resolutedreamer/IR-Breakout/README.md

# IR-Breakout
PCB for a small shield for IR communication - for use with SparkFun GPIO Block for Intel® Edison. Designs in Fritzing.
There are 3 different shields - IR receiver, IR emitter, and a shield that fits both the emitter and receiver.
