resolutedreamer/IR-Breakout/emitter-receiver/IR.Emitter-Receiver_bb.png

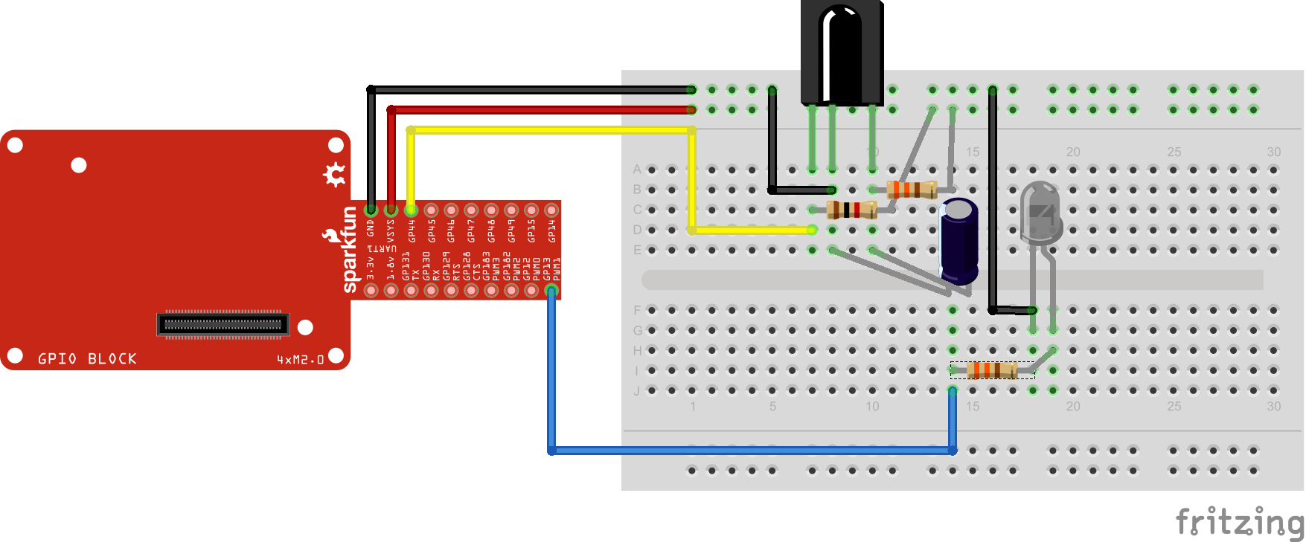
emitter-receiver/IR.Emitter-Receiver_bb.png
