resolutedreamer/IR-Breakout/emitter-receiver/IR.Emitter-Receiver_pcb_bottom.png

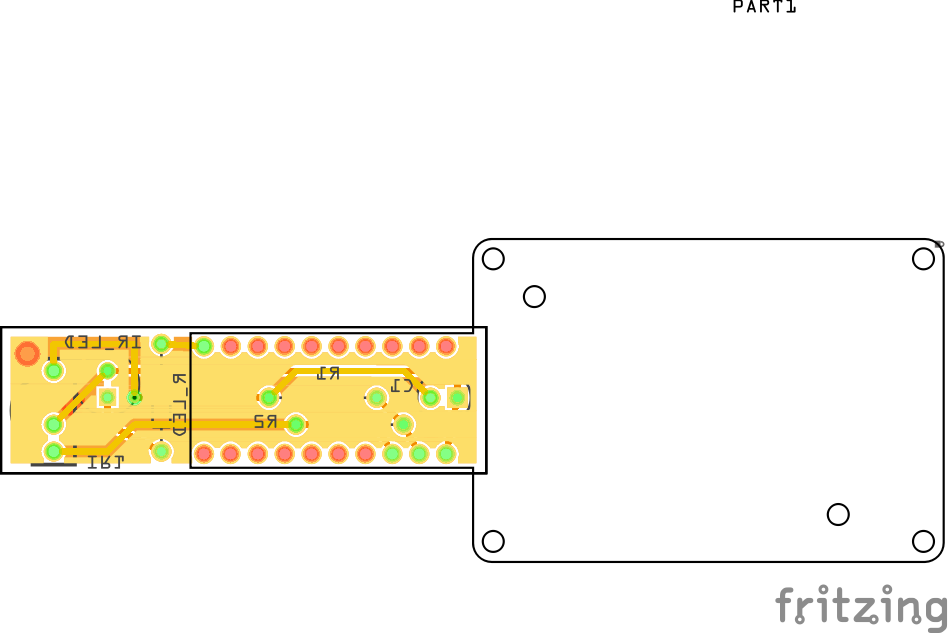
emitter-receiver/IR.Emitter-Receiver_pcb_bottom.png
