resolutedreamer/IR-Breakout/emitter-receiver/IR.Emitter-Receiver_schem.png

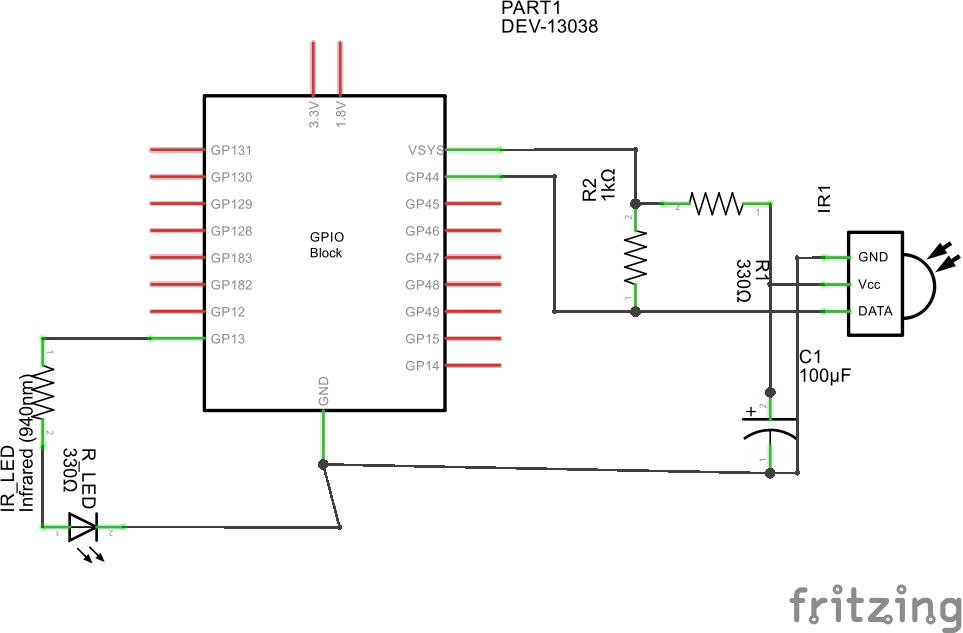
emitter-receiver/IR.Emitter-Receiver_schem.png
