resolutedreamer/IR-Breakout/emitter/IR.Emitter_pcb_bottom.png

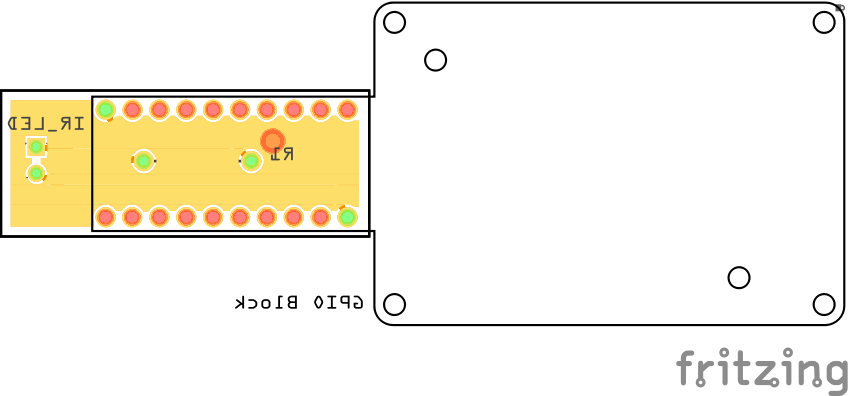
emitter/IR.Emitter_pcb_bottom.png
