resolutedreamer/IR-Breakout/emitter/IR.Emitter_schem.png

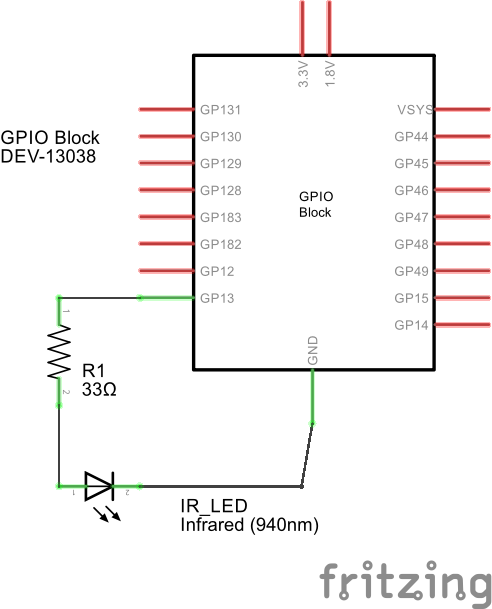
emitter/IR.Emitter_schem.png
