resolutedreamer/IR-Breakout/receiver/TSOP312__.TSOP314__/IR.Receiver.TSOP312__.TSOP314___pcb_bottom.png

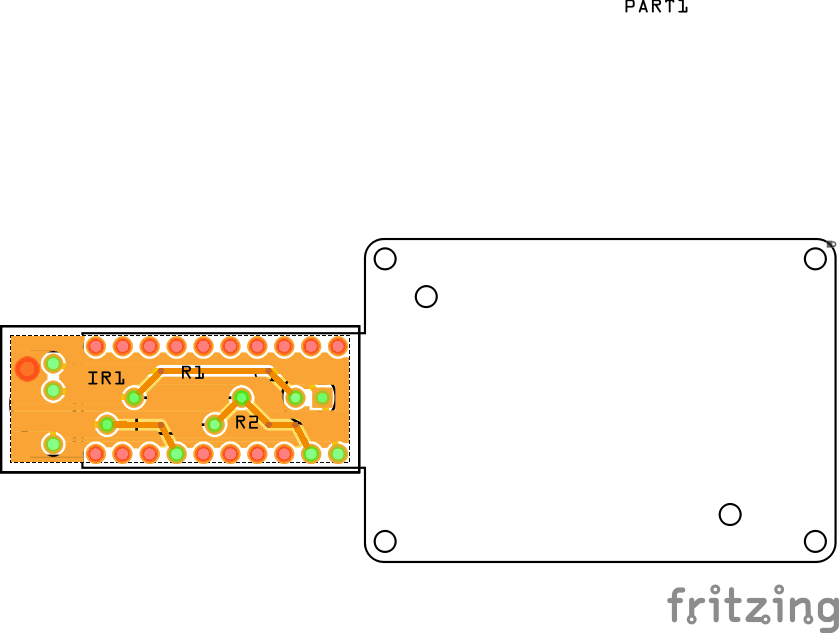
receiver/TSOP312__.TSOP314__/IR.Receiver.TSOP312__.TSOP314___pcb_bottom.png
