resolutedreamer/IR-Breakout/receiver/TSOP312__.TSOP314__/IR.Receiver.TSOP312__.TSOP314___schem.png

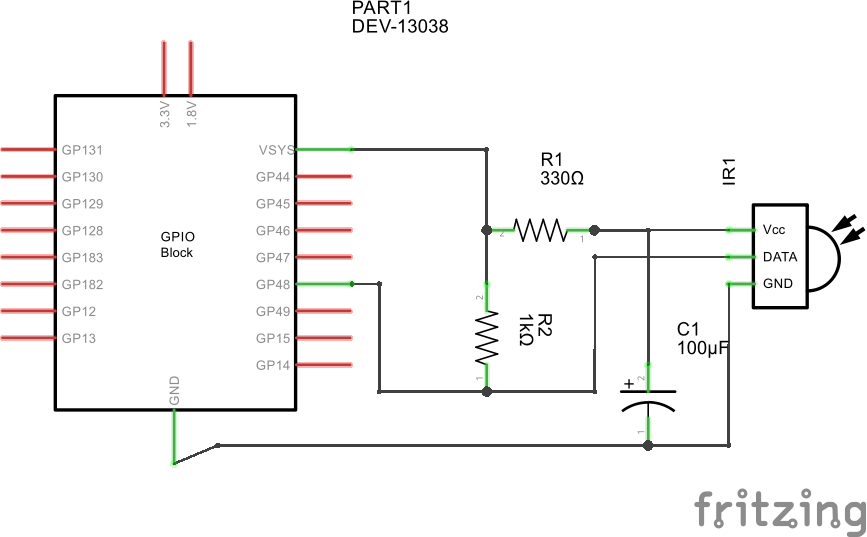
receiver/TSOP312__.TSOP314__/IR.Receiver.TSOP312__.TSOP314___schem.png
