resolutedreamer/IR-Breakout/receiver/TSOP38238/IR.Receiver.TSOP38238_bb.png

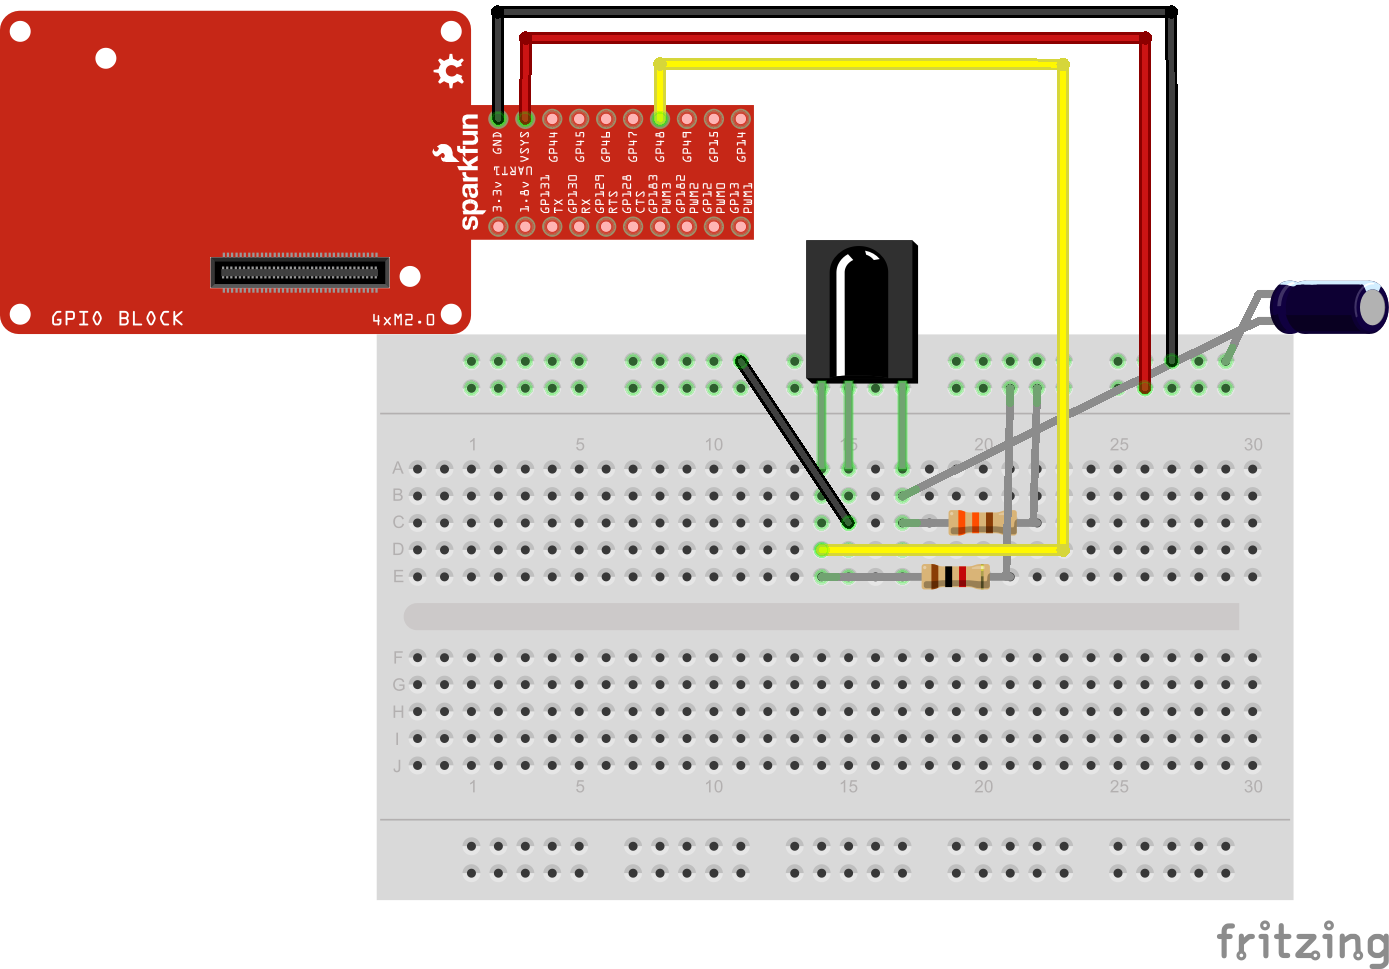
receiver/TSOP38238/IR.Receiver.TSOP38238_bb.png
