resolutedreamer/IR-Breakout/receiver/TSOP38238/IR.Receiver.TSOP38238_schem.png

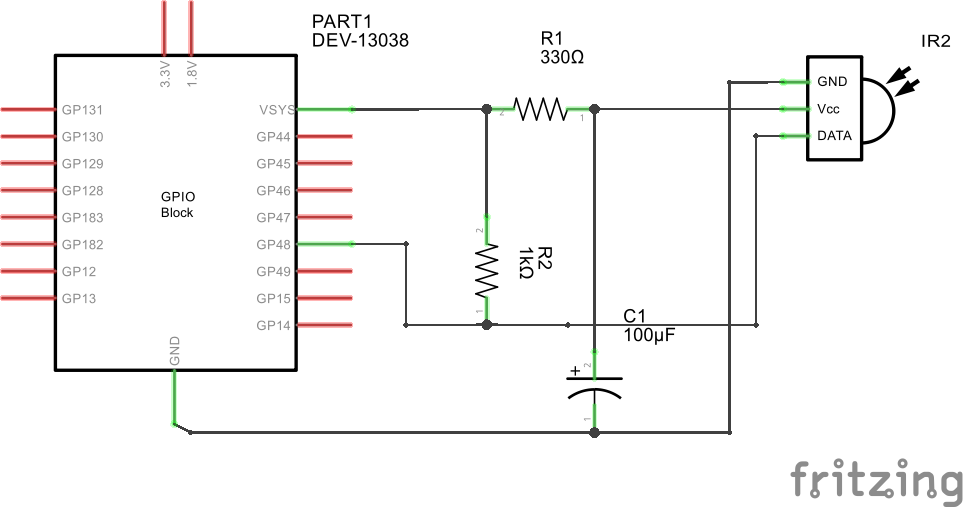
receiver/TSOP38238/IR.Receiver.TSOP38238_schem.png
