resolutedreamer/IR-Breakout/(list of files, drawings)

Other design files:
emitter-receiver/IR.Emitter-Receiver.fzz
emitter/IR.Emitter.fzz
receiver/TSOP312__.TSOP314__/IR.Receiver.TSOP312__.TSOP314__.fzz
receiver/TSOP38238/IR.Receiver.TSOP38238.fzz
