resolutedreamer/IR-Breakout/(commit log)

2016-03-02 Initial version of IR Receiver Board
    [IR.Receiver.fzz]
2016-03-02 second version of IR Receiver Board
    [IR.Receiver.fzz]
2016-03-02 third version of IR Receiver
    [IR.Receiver.fzz]
2016-03-02 Added TSOP38238
    The Fritzing Library of parts comes with an IR Receiver Diode from the TSOP312 series, and it turns out the pin-out is different on this device than the ones from SparkFun at https://www.sparkfun.com/products/10266. I wanted my PCB to match this part, so I edited the pin-out of the original Fritzing Part to match this IR Receiver diode.
2016-03-02 Updated with TSOP38238
    After creating the part for the TSOP38238, I needed to go back to the PCB and re-arrange the connections to match the new part.
    [IR.Receiver.TSOP38238.fzz]
2016-03-02 Renamed Original PCB File
    I renamed the file IR.Receiver.fzz to
    IR.Receiver.TSOP312__.TSOP314__.fzz to indicate that this PCB uses the
    pinout for those devices and works best with them.
    [IR.Receiver.TSOP312__.TSOP314__.fzz]
2016-03-02 Reorganized file structure
    [IR.Receiver.TSOP312__.TSOP314__.fzz, IR.Receiver.TSOP38238.fzz]
2016-03-02 Fixed Reorganization
    Accidentally put the "receiver" in the "emitter" folder
    [IR.Receiver.TSOP312__.TSOP314__.fzz, IR.Receiver.TSOP38238.fzz]
2016-03-02 Added IR Emitter PCB
    [IR.Emitter.fzz]
2016-03-02 Added IR Emitter-Receiver PCB
    [IR.Emitter-Receiver.fzz]
2016-03-02 Updated IR Emitter
    Changed the LED to properly display as IR, rearranged labels and applied
    copper fill to PCB.
    [IR.Emitter.fzz]
2016-03-06 Added Finalized Files to Receiver PCB Folders
    [IR.Receiver.TSOP312__.TSOP314__.fzz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]
2016-03-06 Added finalized files to other PCB folders
    [IR.Emitter-Receiver.fzz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]
